107040503/cortex-m0-int8-npu-soc/docs/kc705_arm_200mhz_goal_20260701.md

# KC705 ARM/Cortex-M0 + NPU 200MHz Goal Analysis

## 1. Scope And Assumptions

- Current scope is ARM/Cortex-M0 only. RISC-V/PicoRV32 is not part of this stage.
- The target FPGA board is KC705 with `xc7k325tffg900-2`.
- ILA must stay enabled. Do not use `-NoIla` and do not remove `ila_cpu_npu_kc705`.
- A bitstream with negative post-route WNS is not valid 200MHz signoff evidence, even if Vivado can generate it.
- No false path or multicycle path is added to the obfuscated Cortex-M0 internal logic without structural proof.

## 2. External Reference Findings

- AMD/Xilinx KC705 documentation identifies KC705 as a Kintex-7 evaluation board using the `XC7K325T` device family. The current Vivado part and board settings match the KC705 target.
- AMD Vivado timing-closure documentation treats post-route timing summary, critical path analysis, DRC/methodology reports, and QoR reports as signoff evidence. Therefore `WNS < 0` must be treated as a blocker for a 200MHz claim.
- AMD Vivado Hardware Manager and ILA flow supports loading a bitstream with its `.ltx` probe file, triggering ILA, uploading captured samples, and exporting waveform data. This matches the current `program_hw.tcl` and `capture_ila.tcl` automation path.
- Open accelerator projects and papers such as Gemmini, VTA, and NVDLA use the same architectural split that this design uses: CPU control, local memory or scratchpad, DMA/load-store movement, and a dedicated matrix/tensor compute array.
- These references support the architecture and validation method, but they do not replace local Vivado timing and board-capture evidence.

## 3. Current RTL Facts

- Main ARM SoC: `rtl/cortex_m0_npu_soc.v`.
- Cortex-M0 wrapper: `rtl/cortex_m0_designstart_ahb.v`.
- Current CPU instance is Arm DesignStart `CORTEXM0INTEGRATION` from the local package under `doc/AT511-r2p0-00rel0-1`.
- The available `CORTEXM0INTEGRATION` is an obfuscated delivery form. This checkout does not contain a legal non-obfuscated `module CORTEX_M0` that can be swapped in directly, and the wrapper cannot reliably set the `SMUL` multiplier parameter.
- NPU/data-plane modules already match the competition architecture: `npu_core_4x4`, `systolic_array_4x4`, `npu_accel_axi`, `axi_shared_interconnect`, and shared AXI memory.
- The design exposes board-debug evidence signals: `npu_irq`, `npu_array_clk_en`, `cpu_halted`, DMA beat counters, DMA active/data cycle counters, and a cycle counter.

## 4. Verified Simulation Metrics

Command:

```powershell
powershell -ExecutionPolicy Bypass -File scripts\run_all_checks.ps1
```

Current evidence from `docs/metrics_report.md`:

- Main Cortex-M0 integration test passes.
- RTL clock target is `200 MHz`.
- Peak INT8 metric is `1024 MTOPS = 1.024 TOPS`.
- DMA Burst utilization target is `>=80%`, measured value is `85%`.
- Functional coverage model is `28/28 = 100%`.
- Code path coverage model is `52/52 = 100%`.
- Clock-gating and idle power-gate coverage points are hit.

Dual-clock simulation command:

```powershell
powershell -ExecutionPolicy Bypass -File scripts\check_cpu_dual_clock_sim.ps1
```

Current evidence from `sim/tb_cortex_m0_cpu_npu_dual_clock.log`:

- `PASS tb_cortex_m0_cpu_npu_dual_clock`.
- `INFO dual_clock DMA data utilization percent=85`.
- `INFO dual_clock peak mtops=1024`.

## 5. Vivado Single-Clock 200MHz Status

Strict single-clock target:

- `soc_clk_mmcm = 5.000ns / 200.000MHz`.
- Overall `WNS >= 0`.
- DRC has no blocking Error.
- ILA remains enabled.

Current result:

- Multiple implementation experiments have been attempted: default, retiming/DSP optimization, no-DSP multiplier macro, tightened pblock, and no-pblock.
- Best known strict single-clock result is `kc705_200mhz_nodspcpu_nopblock`.
- It has `soc_clk_mmcm = 5.000ns / 200.000MHz`, but post-route `WNS = -3.488ns`.
- The worst paths remain inside `u_soc/u_cpu/u_cortexm0integration/u_logic`.

Conclusion: the current obfuscated Cortex-M0 single-clock SoC cannot yet be claimed as a 200MHz FPGA pass.

## 6. Vivado Dual-Clock Candidate Status

Candidate structure:

- Cortex-M0/AHB-Lite control plane runs on `cpu_clk`.
- NPU, AXI Burst data plane, shared SRAM, and ILA run on `data_clk`.
- CPU AXI-Lite control traffic crosses into the 200MHz domain through `rtl/axil_cdc_bridge.v`.
- NPU DMA remains in the 200MHz data plane.

Implementation command already used:

```powershell
powershell -ExecutionPolicy Bypass -File scripts\run_vivado_kc705_dual_clock_experiment.ps1 -Jobs 4
```

Timing gate command:

```powershell
powershell -ExecutionPolicy Bypass -File scripts\check_vivado_timing_gate.ps1 `
  -TimingReport fpga\vivado\experiments\kc705_200mhz_dual_clock\reports\impl_timing_summary.rpt `
  -ClockName data_clk_mmcm
```

Current result:

- bitstream: `fpga/vivado/bitstreams/kc705_200mhz_dual_clock.bit`
- ltx: `fpga/vivado/bitstreams/kc705_200mhz_dual_clock.ltx`
- report directory: `fpga/vivado/experiments/kc705_200mhz_dual_clock/reports`
- overall `WNS = 0.148ns`, `TNS = 0.000ns`, failing endpoints `0`.
- `data_clk_mmcm = 5.000ns / 200.000MHz`.
- `cpu_clk_mmcm = 20.000ns / 50.000MHz`.
- `data_clk_mmcm` intra-clock WNS is `0.428ns`.
- `cpu_clk_mmcm` intra-clock WNS is `5.469ns`.
- `cpu_clk_mmcm -> data_clk_mmcm` WNS is `0.148ns`.
- DRC has no Error. Current warnings are mainly `REQP-1840`, `PORTPROP-2`, and `RTSTAT-10`.

Boundary: this is valid evidence for a 200MHz NPU/AXI Burst/ILA data plane. It is not evidence that the Cortex-M0 core itself runs at 200MHz.

## 7. Active Goal

Current active goal remains:

> For the ARM/Cortex-M0-only KC705 CPU + self-designed NPU system, reach a real 200MHz acceptance point in simulation and Vivado implementation: RTL regression keeps 1.024 TOPS@INT8, AXI Burst/DMA utilization is at least 80%, functional/path coverage passes; Vivado keeps ILA enabled and has a 5.000ns verification/data clock with final WNS >= 0 and no blocking DRC errors; then complete real-board program + ILA capture and produce a metric report.

The practical target is split into two acceptance routes:

1. Strict route: obtain or instantiate a legal parameterized Cortex-M0 implementation that can close timing at 200MHz, then rerun full RTL regression, Vivado implementation, timing gate, board program, and ILA capture.
2. Candidate route: if the competition explanation allows different CPU and accelerator clocks, use the dual-clock design as the FPGA route, explicitly claiming 200MHz only for the NPU/AXI Burst/ILA data plane and documenting the Cortex-M0 control plane at 50MHz.

## 8. Next Engineering Steps

1. Add a `-TimingClockName` option to `scripts/run_vivado_kc705.ps1`, so program/capture can intentionally gate on `data_clk_mmcm` for the dual-clock bitstream.
2. If using the dual-clock candidate, run real KC705 program with `kc705_200mhz_dual_clock.bit/.ltx`.
3. Capture ILA CSV and check `debug_resetn`, `npu_array_clk_en`, `npu_irq_latched`, DMA read/write beats, DMA active cycles, and DMA data cycles.
4. Parse the ILA capture into a board evidence report, clearly separating simulated 1.024 TOPS/85% utilization metrics from real captured control and activity evidence.
5. Continue looking for a legal parameterized Cortex-M0 source or delivery form if strict Cortex-M0 200MHz is required by the final judging interpretation.

## 9. 2026-07-01 Continuation Evidence

Current script update:

- `scripts/run_vivado_kc705.ps1` now has `-TimingClockName`.
- Default remains `soc_clk_mmcm`, so strict single-clock program/capture is still protected.
- Passing `-TimingClockName data_clk_mmcm` is only for the dual-clock candidate, where the 200MHz claim is limited to the NPU/AXI Burst/ILA data plane.

Hardware enumeration command:

```powershell
& 'E:\Application\Xilinx\Vivado\2019.2\bin\vivado.bat' `
  -mode batch `
  -source fpga\vivado\tcl\list_hw_targets.tcl
```

Observed hardware state:

- hw_server: `localhost:3121`
- target: `localhost:3121/xilinx_tcf/Digilent/210203991573A`
- device: `xc7k325t_0`
- PART: `xc7k325t`
- `PROGRAM.FILE` and `PROBES.FILE` were empty during enumeration because this was a read-only target listing, not a program operation.

Real program status:

- A real program attempt using `kc705_200mhz_dual_clock.bit/.ltx` was not executed because the candidate bitstream is not the strict ARM/Cortex-M0 single-clock 200MHz result.
- This is an intentional boundary: the dual-clock bitstream has valid 200MHz data-plane timing, but the Cortex-M0 control plane is 50MHz.
- The board connection is therefore verified, but the final goal is still active because real program + ILA capture has not been completed under the strict goal or under an explicitly approved dual-clock acceptance route.

## 10. Reference List

- AMD KC705 Evaluation Board User Guide UG810: https://docs.amd.com/v/u/en-US/ug810_KC705_Eval_Bd
- AMD Vivado Design Analysis and Closure Techniques UG906: https://docs.amd.com/r/en-US/ug906-vivado-design-analysis
- AMD Vivado Programming and Debugging UG908: https://docs.amd.com/r/en-US/ug908-vivado-programming-debugging
- Gemmini open-source accelerator generator: https://github.com/ucb-bar/gemmini
- Gemmini paper: https://arxiv.org/abs/1911.09925
- VTA open-source accelerator stack: https://github.com/apache/tvm-vta
- NVDLA open-source deep learning accelerator RTL: https://github.com/nvdla/hw

## 11. 2026-07-01 Research And Code Analysis Addendum

This addendum records the current state after timing-closure attempts, external reference lookup, and a fresh code review. It is intentionally conservative: simulation metrics are counted as achieved only when backed by logs, and FPGA 200MHz is counted as achieved only when Vivado post-route timing is non-negative.

### 11.1 External Reference Summary

- AMD UG810 identifies KC705 as a Kintex-7 `XC7K325T-2FFG900C` evaluation board. This confirms that the current `xc7k325tffg900-2` Vivado part and KC705 board migration are the right FPGA target for this stage.
- AMD UG906 lists timing analysis, timing summary details, DRC, methodology checks, QoR reports, floorplanning, and implementation-closure techniques as the correct evidence chain for timing signoff. Therefore a `WNS < 0` bitstream is not acceptable as a 200MHz result.
- AMD UG908 documents the Vivado programming/debug flow, including bitstream download, Hardware Manager, ILA trigger/capture, waveform viewing, and saving captured ILA data. This matches the current `.bit/.ltx` plus `program_hw.tcl` and `capture_ila.tcl` direction.
- Gemmini, VTA, and NVDLA all support the architectural direction used here: a host CPU or control processor orchestrates a dedicated matrix/tensor accelerator, while local memory, DMA/load-store engines, and performance counters carry the data-plane work. These projects support the architecture choice but do not replace local RTL regression, timing, and board evidence.
- Gemmini is especially relevant because its public documentation describes a systolic array, scratchpad/accumulator SRAMs, DMA movement, runtime dataflow choices, and performance counters. The current project is smaller, but the same proof pattern applies: verify CPU control, accelerator execution, memory movement, and counters separately.

### 11.2 Current ARM-Only Code Facts

- CPU path: `rtl/cortex_m0_designstart_ahb.v` directly instantiates Arm DesignStart `CORTEXM0INTEGRATION`.
- SoC path: `rtl/cortex_m0_npu_soc.v` connects Cortex-M0 AHB-Lite to `ahb_lite_to_axil_bridge`, then to `axi_shared_interconnect`, `npu_accel_axi`, and `axi_bram`.
- KC705 strict top: `fpga/rtl/fpga_kc705_top.v` uses the board 200MHz differential clock and generates `soc_clk_mmcm` with `CLKOUT0_DIVIDE_F=5.000`, so the intended SoC/ILA clock is 5.000ns / 200MHz.
- ILA is retained through `KC705_ENABLE_ILA` and `ila_cpu_npu_kc705`; its probes include `npu_irq`, `npu_irq_latched`, `npu_array_clk_en`, `cpu_halted`, `debug_resetn`, `cycle_counter`, RAM beat counters, and DMA active/data/read/write counters.
- The local DesignStart package contains examples with an `SMUL` multiplier parameter, but the DesignStart obfuscated route explicitly does not pass parameters to `CORTEXM0INTEGRATION`. The current wrapper has no legal parameter hook for changing the internal Cortex-M0 multiplier or retiming the internal logic.

### 11.3 Latest Strict Single-Clock Experiment

Experiment:

```powershell
powershell -ExecutionPolicy Bypass -File scripts\run_vivado_kc705_experiment.ps1 `
  -Jobs 4 `
  -ExperimentName k7e1 `
  -DisableCortexM0Pblock `
  -SynthDirective PerformanceOptimized `
  -PhysOptDirective AggressiveExplore `
  -PostRoutePhysOptDirective AddRetime
```

Result:

- Bitstream and probes were generated as `fpga/vivado/bitstreams/k7e1.bit` and `fpga/vivado/bitstreams/k7e1.ltx`, but this image is not signoff-valid.
- `fpga/vivado/experiments/k7e1/reports/impl_timing_summary.rpt` shows `soc_clk_mmcm = 5.000ns / 200.000MHz`.
- Overall `WNS = -3.636ns`, `TNS = -3450.871ns`, and failing endpoints = `2023`.
- Worst setup path remains inside `u_soc/u_cpu/u_cortexm0integration/u_logic`, from `Aurpw6_reg/C` to `Ydopw6_reg/D`.
- Worst path data delay is `8.611ns`, with 20 logic levels and about 75% route delay.
- DRC has no Error, but warnings remain: `PLBUFGOPT-1`, `PORTPROP-2`, `REQP-1839`, and `RTSTAT-10`.

Conclusion: `k7e1.bit` must not be programmed as a 200MHz signoff bitstream. It is useful only as evidence that current strict single-clock ARM/Cortex-M0 200MHz timing is still blocked by internal Cortex-M0 timing.

### 11.4 Root-Cause Assessment

- The NPU/AXI data-plane architecture is not the current strict 200MHz blocker. The known-good dual-clock implementation closes the NPU/AXI/ILA data plane at 200MHz.
- The strict single-clock blocker is the obfuscated `CORTEXM0INTEGRATION` internal logic on the KC705 `-2` speed-grade device. The worst path is not in user-editable NPU RTL.
- Prior attempts, including no-DSP multiplier macro use, Pblock variations, no-pblock routing, retiming, physical optimization, and post-route retiming, improved or changed symptoms but did not close the roughly 3.5ns negative slack.
- Fixing local warnings such as RAMB async control (`REQP-1839`) is still worthwhile for quality and robustness, but it is unlikely to recover the full 3.6ns single-clock Cortex-M0 slack by itself.
- Adding false paths or multicycle paths through Cortex-M0 internals would be unsafe unless there is structural proof from the processor implementation. No such proof exists in the current checkout.

### 11.5 Goal Definition For 200MHz Competition Compliance

The active engineering goal remains strict and ARM-only:

> Achieve a KC705 ARM/Cortex-M0 + self-designed NPU result where RTL regression remains passing at 200MHz with `1.024 TOPS@INT8`, AXI Burst/DMA utilization at least `80%`, functional/path coverage passing, ILA retained, Vivado implementation proving a 5.000ns clock with `WNS >= 0`, DRC showing no blocking errors, and real KC705 program plus ILA capture validating reset release, NPU activity, IRQ completion, DMA counters, and clock-gating behavior.

Acceptance gates:

1. RTL simulation: `scripts/run_all_checks.ps1` passes, `docs/metrics_report.md` still reports 200MHz, 1.024 TOPS, 85% DMA utilization, and 100% functional/path coverage model.
2. Strict Vivado route: `soc_clk_mmcm` period is 5.000ns, post-route `WNS >= 0`, `TNS = 0`, failing endpoints = 0, and DRC has no Error.
3. Board route: only a signoff-valid bitstream is programmed; ILA capture exports data showing `debug_resetn` release, `npu_array_clk_en` asserted during computation and deasserted at idle, `npu_irq_latched` completion, and nonzero DMA read/write/data counters.
4. Report route: the final report separates simulation performance estimates from board-captured activity evidence and cites the Vivado reports used for timing signoff.

Primary next route:

- Obtain or integrate a legal parameterized/non-obfuscated Cortex-M0 implementation, or an Arm-supported configuration of the current integration layer, that allows the multiplier and internal timing structure to close at 200MHz on KC705.
- If that source/configuration is available, replace only the CPU wrapper/filelist layer, rerun ARM-only RTL regression, then rerun strict KC705 200MHz implementation with ILA enabled.

Fallback route only if explicitly accepted:

- Use the already timing-clean dual-clock candidate as an FPGA validation route for the 200MHz NPU/AXI/ILA data plane, while documenting that the Cortex-M0 control plane runs at 50MHz. This can support an honest FPGA demonstration, but it is not the same as strict single-clock ARM/Cortex-M0 200MHz.

## 12. 2026-07-01 Strict 200MHz Goal After Research

This section records the current goal after checking official FPGA documentation, related open accelerator projects, papers, and the local RTL/Vivado evidence. It supersedes any weaker interpretation in which a negative-WNS bitstream or a CPU clock below 200MHz would be counted as a strict ARM/Cortex-M0 200MHz pass.

### 12.1 External Sources Used

- AMD UG810 confirms that KC705 targets the Kintex-7 `XC7K325T-2FFG900C` FPGA, matching the current Vivado part family and board migration: https://docs.amd.com/v/u/en-US/ug810_KC705_Eval_Bd
- AMD UG906 defines the Vivado evidence chain used here: timing summary, timing paths, DRC, methodology, utilization, floorplanning, and timing-closure analysis. A run with `WNS < 0` remains a failing timing run even if bitstream generation completes: https://docs.amd.com/r/en-US/ug906-vivado-design-analysis
- AMD UG908 defines the board-debug evidence chain used here: implemented bitstream download, Hardware Manager, ILA waveform capture, and exported debug data: https://docs.amd.com/r/en-US/ug908-vivado-programming-debugging
- Gemmini supports the same architectural proof pattern used in this project: CPU/software control around a systolic accelerator, local memories, DMA/load-store movement, and performance counters. It is reference evidence only, not a replacement for this RTL's timing and board reports: https://github.com/ucb-bar/gemmini and https://arxiv.org/abs/1911.09925
- VTA and NVDLA are useful open-source references for accelerator verification structure, runtime/software integration, and RTL/testbench packaging: https://github.com/apache/tvm-vta and https://github.com/nvdla/hw
- Additional systolic-array literature supports the use of INT8 GEMM/systolic dataflow for edge inference acceleration, but local pass/fail status is still based on this repository's regression, Vivado timing, and KC705 ILA evidence.

### 12.2 Local Design Findings

- The current scope is ARM-only. RISC-V evidence is intentionally excluded for this stage.
- `fpga/rtl/fpga_kc705_top.v` already generates `soc_clk_mmcm` from the KC705 200MHz differential input with a 5.000ns period, and ILA is clocked by the same `soc_clk`.
- `rtl/cortex_m0_designstart_ahb.v` directly instantiates the local Arm DesignStart `CORTEXM0INTEGRATION` with no parameter list. The checked DesignStart example systems show that the obfuscated DesignStart path does not pass parameters, while the non-obfuscated Cortex-M0 path would pass parameters such as `SMUL`.
- `rg` over the local Arm package found only one `module CORTEXM0INTEGRATION` definition and no directly usable non-obfuscated `module CORTEX_M0` implementation in this checkout.
- The strict latest complete experiment, `k7e1`, has `soc_clk_mmcm = 5.000ns / 200.000MHz`, no DRC Error, but fails setup timing with `WNS = -3.636ns`, `TNS = -3450.871ns`, and `2023` failing endpoints.
- The `k7e1` worst setup path is inside `u_soc/u_cpu/u_cortexm0integration/u_logic`, from `Aurpw6_reg/C` to `Ydopw6_reg/D`, with `8.611ns` data path delay, `20` logic levels, and about `75%` route delay.
- The incomplete `k7e2` directory is not evidence. It only contains a short ILA OOC `runme.log` after the interrupted run and has no valid implementation reports.

### 12.3 Goal Locked For The Next Pass

Strict goal:

> Deliver an ARM/Cortex-M0-only KC705 CPU + self-designed NPU implementation in which RTL simulation remains at 200MHz with `1.024 TOPS@INT8`, AXI Burst/DMA utilization remains at least `80%`, functional/path coverage remains passing, ILA remains enabled, Vivado post-route timing proves `soc_clk_mmcm = 5.000ns / 200.000MHz` with `WNS >= 0`, DRC has no blocking Error, and the real KC705 board is programmed only with that signoff-valid bitstream before ILA capture is used as board evidence.

Hard gates:

1. Do not program a negative-WNS bitstream as a 200MHz result.
2. Do not remove `KC705_ENABLE_ILA` or `ila_cpu_npu_kc705` to close timing.
3. Do not use false-path or multicycle exceptions through Cortex-M0 internals unless there is a processor-level structural proof. None is present in the current checkout.
4. Count the dual-clock bitstream only as a fallback FPGA demonstration for the 200MHz NPU/AXI/ILA data plane, not as strict Cortex-M0-at-200MHz compliance.

Primary route:

1. Keep the existing RTL regression and metrics scripts as the functional/performance baseline.
2. Continue strict Vivado timing experiments only if they preserve the ARM Cortex-M0 path, the 5.000ns `soc_clk_mmcm` target, and ILA.
3. If implementation strategies stay near `-3.5ns`, stop strategy-only exploration and switch to a structural CPU route: obtain a legal non-obfuscated/parameterized Cortex-M0 implementation or Arm-supported configuration that can change the internal multiplier/timing structure, then re-run the full ARM-only flow.
4. After a passing strict bitstream exists, run program + ILA capture and generate the board metric report.

### 12.4 Vivado Tool-Flow Update

- `k7e2` and `k7e3` both stopped at the ILA OOC synthesis child run with `rundef.js(121, 5) JavaScript runtime error: Access denied`.
- `k7e4` disabled the ILA OOC checkpoint and kept ILA in the design, but the main `synth_1` run still hit the same `rundef.js` access error. This shows the blocker is Vivado 2019.2's Windows `launch_runs` wrapper path, not ILA removal or RTL syntax.
- Added `fpga/vivado/tcl/run_kc705_200mhz_direct.tcl`, which avoids `launch_runs` and directly calls `synth_design`, `opt_design`, `place_design`, `phys_opt_design`, `route_design`, and `write_bitstream` in one Vivado Tcl process.
- Direct experiment `k7d1` successfully completed synthesis with ILA present and entered implementation. It did not complete within the current timeout window, and no post-route timing report was produced, so it is not a signoff result.
- Next strict implementation attempt should use the direct-flow Tcl with either a longer allowed runtime or a less expensive directive set. The strict signoff gate remains unchanged: `soc_clk_mmcm = 5.000ns / 200.000MHz`, `WNS >= 0`, no blocking DRC Error, ILA retained.
