107040503/cortex-m0-int8-npu-soc/docs/metrics_report.md

# Metrics Report

Generated from Icarus Verilog logs in `sim/`.

## Simulation Pass Status

- tb_axi_burst_dma.log: PASS tb_axi_burst_dma
- tb_cortex_m0_cpu_npu.log: PASS tb_cortex_m0_cpu_npu
- tb_hetero_soc.log: PASS tb_hetero_soc
- tb_npu_core_4x4.log: PASS tb_npu_core_4x4
- tb_npu_stress.log: PASS tb_npu_stress
- No FAIL lines found in current logs.

## Functional Coverage

- Required functional coverage points: 28
- Hit functional coverage points: 28
- Functional coverage score: 100%

- [hit] core_basic_matmul
- [hit] core_signed_int8
- [hit] core_clock_gate_idle
- [hit] axi_incr_write_burst
- [hit] axi_incr_read_burst
- [hit] axi_wlast_rlast
- [hit] soc_axil_control
- [hit] soc_dma_burst_read_write
- [hit] soc_irq_done
- [hit] soc_bus_util_over_80
- [hit] soc_peak_over_1tops
- [hit] soc_power_gate_idle
- [hit] undefined_register_read
- [hit] dynamic_pe_mask_single_pe
- [hit] dfs_divider_slow_mode
- [hit] clear_done
- [hit] irq_disable
- [hit] repeated_start
- [hit] dfs_full_speed_mode
- [hit] auto_power_gate_idle
- [hit] actual_cortex_m0_ahb_config
- [hit] actual_cortex_m0_ahb_to_axil_bridge
- [hit] actual_cortex_m0_cpu_npu_poll
- [hit] actual_cortex_m0_npu_irq
- [hit] actual_cortex_m0_zero_copy_addresses
- [hit] actual_cortex_m0_designstart_firmware
- [hit] cortex_m0_peak_over_1tops
- [hit] cortex_m0_bus_util_over_80

## Code Path Coverage Model

- Required path coverage points: 52
- Hit path coverage points: 52
- Code path coverage score: 100%

- [hit] core_state_idle
- [hit] core_state_clear
- [hit] core_state_run
- [hit] core_state_done
- [hit] core_dfs_div0_tick
- [hit] core_pe_mask_all_enabled
- [hit] core_signed_positive_negative_zero
- [hit] core_array_clk_gate_idle
- [hit] axi_ram_aw_accept
- [hit] axi_ram_wdata_beats
- [hit] axi_ram_wlast_response
- [hit] axi_ram_ar_accept
- [hit] axi_ram_rdata_beats
- [hit] axi_ram_rlast_finish
- [hit] axi_ram_incr_address
- [hit] axi_ram_beat_counters
- [hit] axil_write_a_addr
- [hit] axil_write_b_addr
- [hit] axil_write_c_addr
- [hit] axil_write_pe_mask
- [hit] axil_write_ctrl_start_irq
- [hit] axil_read_status_busy_done
- [hit] axil_read_dma_counters
- [hit] axil_read_peak_mtops
- [hit] axil_read_power_ctrl
- [hit] npu_fsm_idle_to_read_a
- [hit] npu_fsm_read_a_ar
- [hit] npu_fsm_read_a_r
- [hit] npu_fsm_read_b_ar
- [hit] npu_fsm_read_b_r
- [hit] npu_fsm_core_start_wait
- [hit] npu_fsm_write_c_aw
- [hit] npu_fsm_write_c_w
- [hit] npu_fsm_write_c_b_done
- [hit] dma_data_util_counter
- [hit] dma_read_write_beat_counters
- [hit] irq_latched_done
- [hit] power_gate_idle_status
- [hit] axil_default_read_path
- [hit] pe_mask_single_enabled_path
- [hit] dfs_wait_increment_path
- [hit] dfs_divider_nonzero_path
- [hit] ctrl_clear_done_path
- [hit] ctrl_irq_disable_path
- [hit] repeated_start_path
- [hit] dfs_divider_zero_path
- [hit] power_auto_gate_status_path
- [hit] cortex_m0_ahb_write_npu_regs
- [hit] cortex_m0_ahb_read_npu_status
- [hit] cortex_m0_ahb_to_axi_lite_bridge
- [hit] cortex_m0_shared_interconnect_cpu_to_npu
- [hit] cortex_m0_shared_interconnect_npu_dma_to_ram

## Performance And Power Evidence

- tb_cortex_m0_cpu_npu.log: INFO cortex_m0 DMA data utilization percent=85
- tb_cortex_m0_cpu_npu.log: INFO cortex_m0 peak mtops=1024
- tb_hetero_soc.log: INFO soc DMA data utilization percent=85
- tb_hetero_soc.log: INFO soc peak mtops=1024
- tb_npu_stress.log: INFO stress dfs_wait_cycles=22
- RTL clock target: 200 MHz
- Peak INT8 metric register: 1024 MTOPS = 1.024 TOPS
- DMA burst utilization target: >=80%, measured: 85%
- Cortex-M0 integration evidence: official DesignStart CORTEXM0INTEGRATION executes Thumb firmware, performs AHB-Lite writes/reads, drives the AHB-to-AXI-Lite bridge, polls IRQ/done, and passes zero-copy addresses
- Clock gating/power-gate evidence: soc_power_gate_idle and auto_power_gate_idle coverage points hit

## Notes

This is a functional coverage report generated from self-checking Icarus testbenches.
Line/branch/toggle code coverage requires an additional coverage tool such as Verilator or covered.
