107040503/cortex-m0-int8-npu-soc/(commit log)

2026-07-02 Prepare Cortex-M0 NPU project for GitHub
    [20260629_222851_hw_ila_1.csv]
2026-07-03 Add RISC-V 200MHz KC705 flow
